zacsketches/MaryLou/Datasheets/Simpson.jpeg

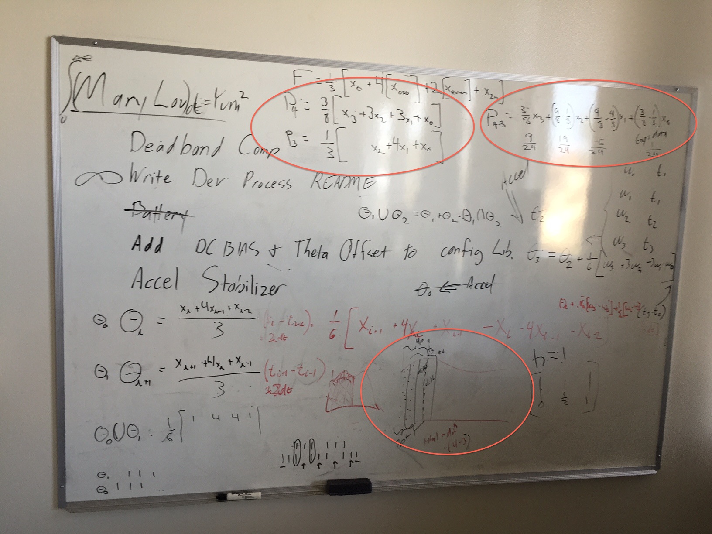
Datasheets/Simpson.jpeg
