zacsketches/MaryLou/build_notes.txt

Bill of Materials:
     Glow Worm robotics framework
     Arduino Due
     Arduino Motor Shield
     Pololu 10 DOF IMU v2
     XBEE
     3-cell lipo battery
     2 x Pololu 37D mm 19:1 gearmotor
     2 x Pololu stamped Al L-Bracket for 37D mm gearmotors
     2 x Pololu universal mounting hubs
     2 x Pololu ?? x 8mm wheels
     4 x 3/4" nylon standoffs
     custom power and signal distribution boards
     
1. Start here on Due and motor shield
     http://arduino.cc/en/Tutorial/DueMotorShieldDC

2. Great ref for quadrature encoding
    http://letsmakerobots.com/node/24031

3. The plant will need to attach two encoder motors and
subscribe to the control_effort message.  It will
publish a plant status message with the following fields
    long rt_ct
    float rt_I //mv
    long lt_ct
    float lt_I
    uint32_t timestamp   //microseconds
    
5. Consider having the plant balance counts between the
two motors.
    
4. The attitude computer will hold pointers to an accel object 
and a magnetometer object, and will need to publish a message
called pitch with the following data:
    int theta    //pitch neg falling back, pos frwd
    uint32_t timestamp   //microseconds
    
5. The state observer will subscribe to the 
pitch message and the plant_status_msg and publish
the state_vec_msg with the following fields
    double theta
    double theta_dot
    double x
    double x_dot
    
6. The balance regulator will subscribe to the 
state_vec_msg and publish the control_effort_msg
with the following field:
    int u
    
7. Have clearinghouse use publish_serial on the
messages of interest for debugging.

8. //Physical connections
const int lt_dir_pin = 12;
const int lt_pwm_pin = 3;
const int lt_sense_pin = A0;
const int lt_encoder_A_pin = 7;
const int lt_encoder_B_pin = 6;

const int rt_dir_pin = 13;
const int rt_pwm_pin = 11;
const int rt_sense_pin = A1;
const int rt_encoder_A_pin = 5;
const int rt_encoder_B_pin = 4;

9. Outstanding resource for IMU info:
     https://code.google.com/p/ardu-imu/wiki/Theory
     
10. The atan or atan2 function is used to calculate pitch
angle directly from the accelerometer.  The Freescale 
Application Note 3461 gives an outstanding explanation of
this.  See AN3461 in the Datasheets folder of the 
project.

11. The atan and atan2 functions resolve their 
result with differing rules about quadrants.  In 
essence atan give a result only in quadrant I or IV.
Whereas atan2 solves for the result in all four 
quadrants.  See this link for a thorough explanation:
    http://stackoverflow.com/questions/283406/what-is-the-difference-between-atan-and-atan2-in-c
    
12. Used basic technique for PI controller tuning on the 
attitude computer with ideas from Zeiger-Nichols method.  
See here for an overview:
     http://en.wikipedia.org/wiki/Ziegler%E2%80%93Nichols_method

13. The deadband lab saved in the datasheets is also a good reference
for control of an atmega32 on the same PCB as an L293.
     http://claymore.engineer.gvsu.edu/~jackh/eod/courses/egr345/fall05/lab_deadband.pdf
I implemented deadband compensation as a linear scaling.  Each gw::Motor now
has a function to set_deadband(int forward, int reverse).  PWM signals
falling between these values will be scaled with the Arduino map() function
like this:
	pwm_compensated = map(pwm_raw, 0, 255, deadband_limit, 255);
Then the compensated value will be written to the motor.  The gw::Motor
default values for deadband are (0,0).  So if they are not set then no
scaling will occur.
    
14. The MATLAB example for control of an inverted pendulum is a great
reference for the statespace controller necessary for this project.
	http://ctms.engin.umich.edu/CTMS/index.php?example=InvertedPendulum&section=SystemModeling

15. Wikipedia has a good article on moments of inertia. I think we will
be able to compute the moment of inertia for our pendulum based off
the system they give for compound pendulums.

16. MATLAB equations of motion, where phi is the linearized theta:
	(I+m*l^2)phi_double_dot - m*g*l*phi = m*l*x_double_dot
	(M+m)x_double_dot + b*x_dot - m*l*phi_double_dot = u
	
17. Ogata has the same equations, but does not consider the x_dot friction
component in the second equation.  We might need to take this route because
it's going to be hard to measure friction between the tires and body.  Finally,
there is an interesting discussion from Stanford at:
	http://web.stanford.edu/class/me161/documents/InvertedPendulumOnCartSolution.pdf

18. Because MaryLou is an irregular shape computing I, necessary for the equations
in note 16, is not trivial.  See these YouTube videos for background on 
computing the Mass Moment of Inertia by suspending it from the ceiling.
	https://www.youtube.com/watch?v=m9iHEanmNWc
	https://www.youtube.com/watch?v=tfrzMczTv8g
	https://www.youtube.com/watch?v=4lcVQzdK_vE

19. I found a good resource on committing just a single file or group of files from
one branch into another.  I've included it here so I can find it again later.
	http://jasonrudolph.com/blog/2009/02/25/git-tip-how-to-merge-specific-files-from-another-branch/
