zacsketches/MaryLou/Solidworks/Frame.SLDASM

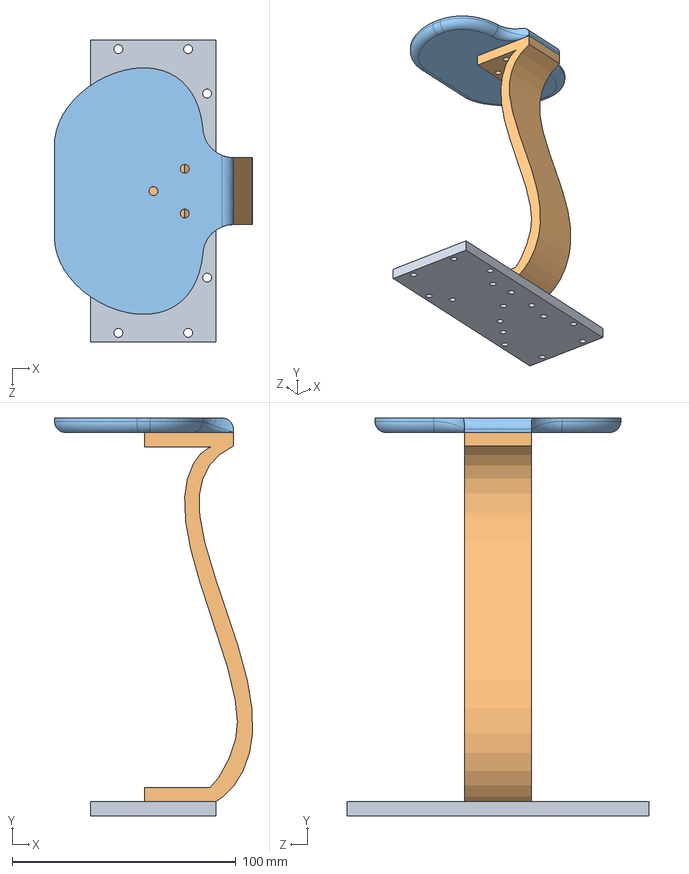
[picture p2: CAD file, 2014-10-09]
Solidworks/Frame.SLDASM
88.6 x 178.0 x 134.9 mm
baseplate
neck
Table
