zacsketches/MaryLou/Solidworks/neck.SLDPRT

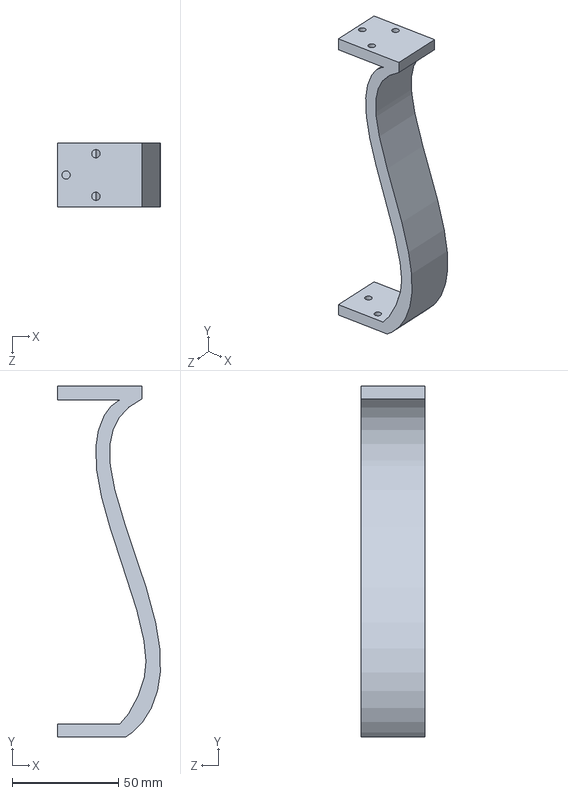
[picture p3: CAD file, 2014-10-25]
Solidworks/neck.SLDPRT
48.3 x 165.0 x 30.0 mm
