zacsketches/MaryLou/Solidworks/Table.SLDPRT

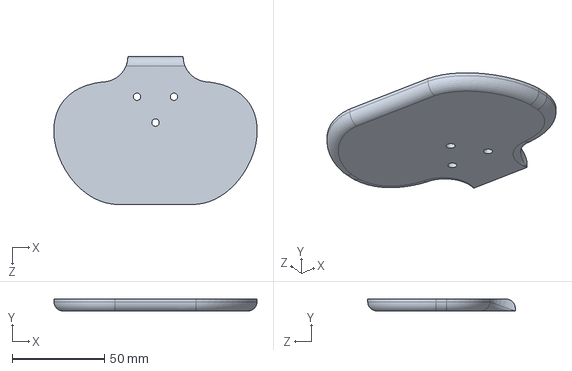
[picture p4: CAD file, 2014-10-09]
Solidworks/Table.SLDPRT
110.0 x 6.50 x 80.0 mm
