zacsketches/MaryLou/Solidworks/baseplate.SLDPRT

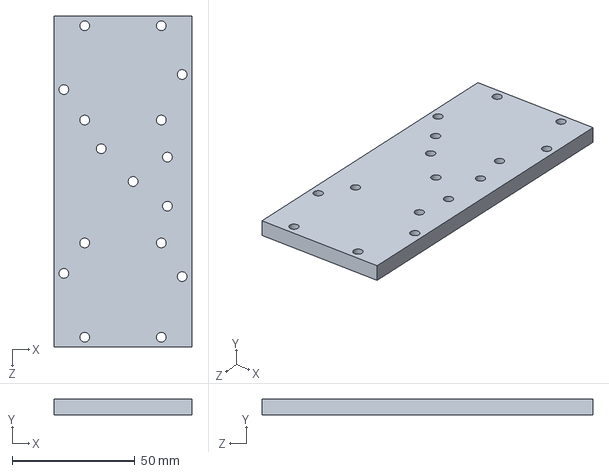
[picture p5: CAD file, 2014-10-08]
Solidworks/baseplate.SLDPRT
56.2 x 6.50 x 134.9 mm
