zacsketches/MaryLou/(list of files, cad)

Other CAD files:
Solidworks/Table.STL
Solidworks/baseplate.SLDDRW
Solidworks/baseplate.STL
Solidworks/neck.SLDDRW
Solidworks/neck.STL
