zacsketches/MaryLou/(list of files, drawings)

Other design files:
PCBs/lower.pcb
PCBs/top.pcb
PCBs/upper_pcb/top.pcb
