zacsketches/MaryLou/PCBs/LowerBoard_r1.brd

## EAGLE design PCBs/LowerBoard_r1.brd (2014-12-12)

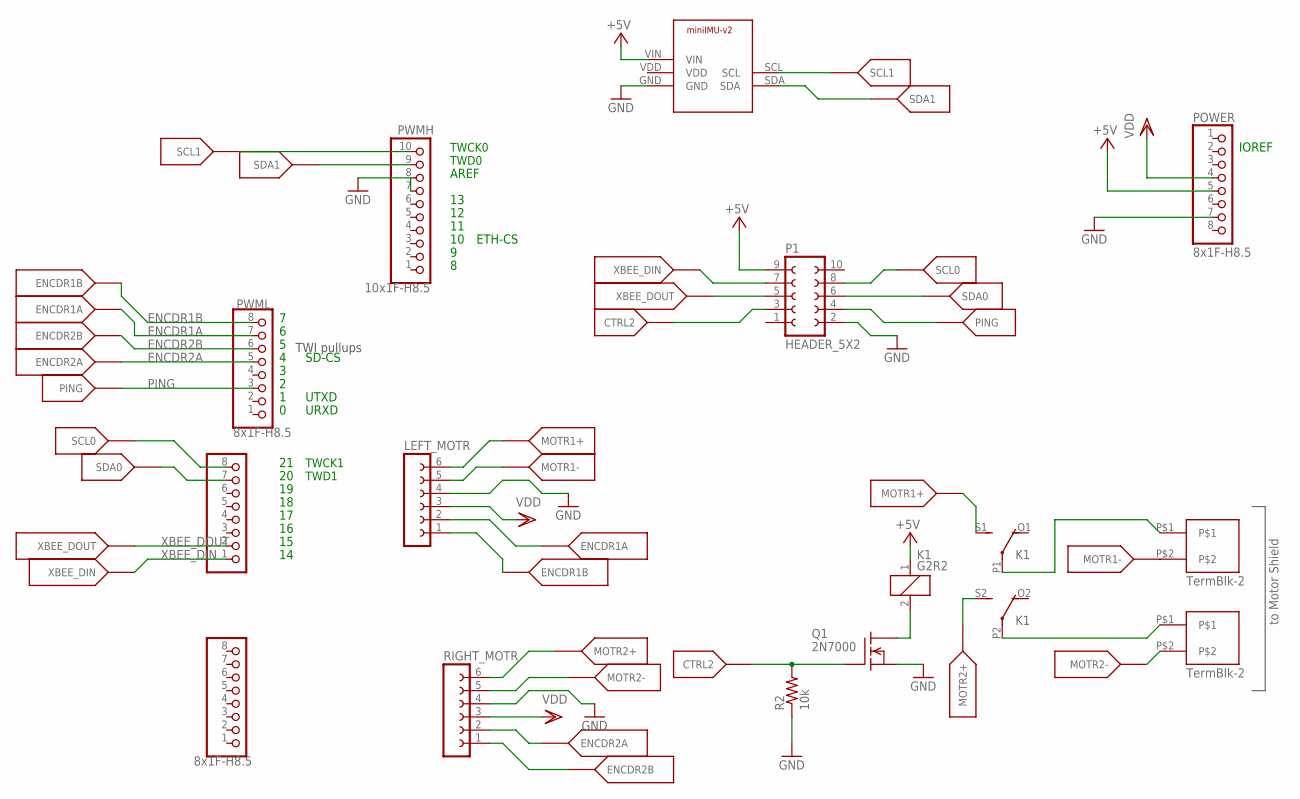
[picture p6: schematic LowerBoard_r1.sch]

Parts:
ANALOG: 8x1F-H8.5; 1X08
COMMS: PINHD-1X8; 1X08
K1: G2R2
LEFT_MOTR: FE06-1; FE06
P1: HEADER_5X2
POWER: 8x1F-H8.5; 1X08
PWMH: 10x1F-H8.5; 1X10
PWML: 8x1F-H8.5; 1X08
Q1: 2N7000; TO92
R2: 10k; RESISTOR_PKG
RIGHT_MOTR: FE06-1; FE06
U$5: POLOLU_MINIIMU9_V2; POLOLU_IMU9V2
U$11: motor1; TB2_PKG
U$12: TB2; TB2_PKG

Connections:
+5V: K1.1, P1.9, POWER.5, U$5.VIN
CTRL2: P1.3, Q1.G, R2.2
ENCDR1A: LEFT_MOTR.2, PWML.7
ENCDR1B: LEFT_MOTR.1, PWML.8
ENCDR2A: PWML.5, RIGHT_MOTR.2
ENCDR2B: PWML.6, RIGHT_MOTR.1
GND: LEFT_MOTR.4, P1.2, POWER.7, PWMH.7, Q1.S, R2.1, RIGHT_MOTR.4, U$5.GND
MOTR1+: K1.S1 (S), LEFT_MOTR.6
MOTR1-: LEFT_MOTR.5, U$11.P$2
MOTR2+: K1.S2 (S), RIGHT_MOTR.6
MOTR2-: RIGHT_MOTR.5, U$12.P$2
unnamed: K1.P1, U$11.P$1
unnamed: K1.P2, U$12.P$1
unnamed: K1.2, Q1.D
PING: P1.4, PWML.3
SCL: PWMH.10, U$5.SCL
SCL0: COMMS.8, P1.8
SDA: PWMH.9, U$5.SDA
SDA0: COMMS.7, P1.6
VDD: LEFT_MOTR.3, POWER.4, RIGHT_MOTR.3
XBEE_DIN: COMMS.1, P1.7
XBEE_DOUT: COMMS.2, P1.5

Notes on the sheet:
TWI pullups
TWCK1
TWD1
IOREF
TWCK0
TWD0
AREF
SD-CS
UTXD
URXD
ETH-CS
to Motor Shield

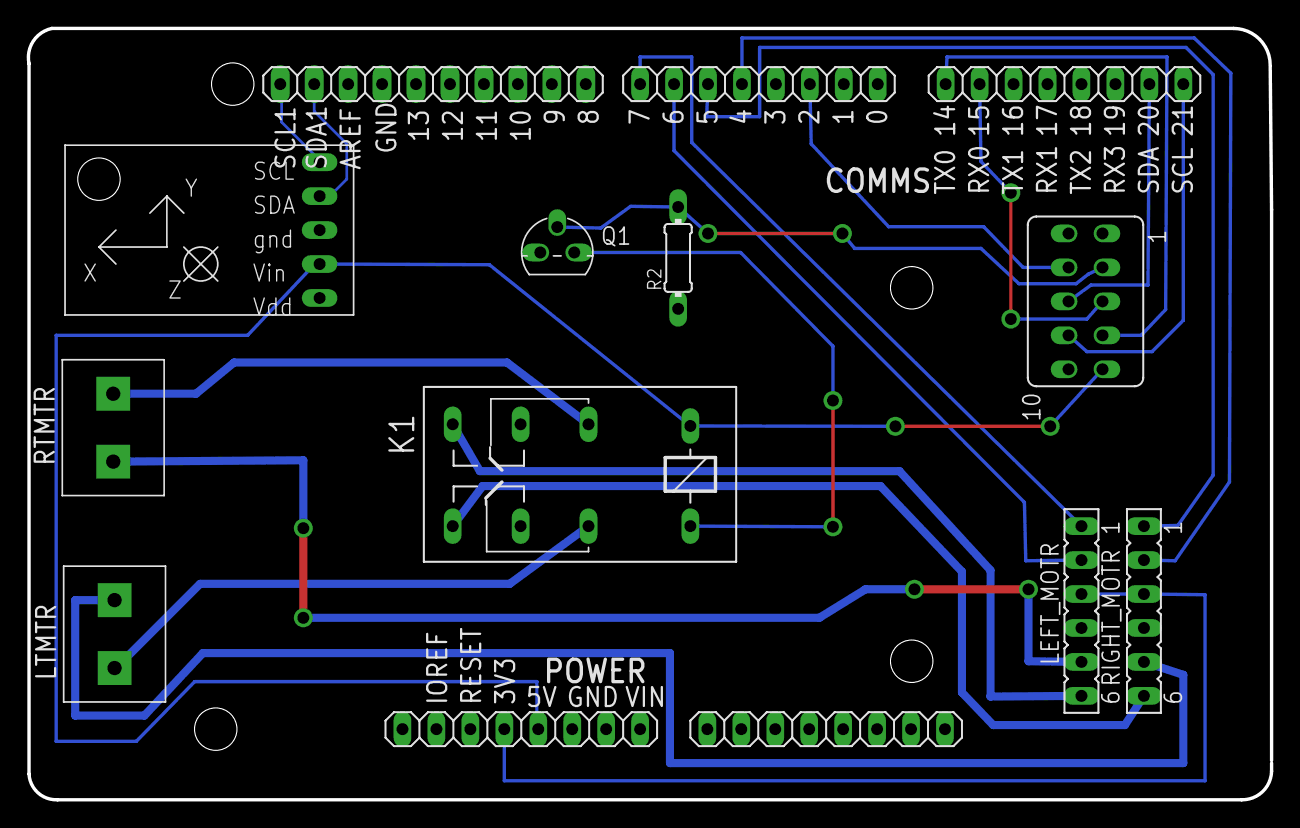
[picture p7: board LowerBoard_r1.brd from above]

Board: 2 copper layers, 93.0 x 57.7 mm, 15 parts (0 on the bottom side), 22 nets.

Other parts of the board:
DRILEGEND: DRILEGEND
