zacsketches/MaryLou/PCBs/upper_pcb/upperBoard.brd

## EAGLE design PCBs/upper_pcb/upperBoard.brd (2014-12-12)

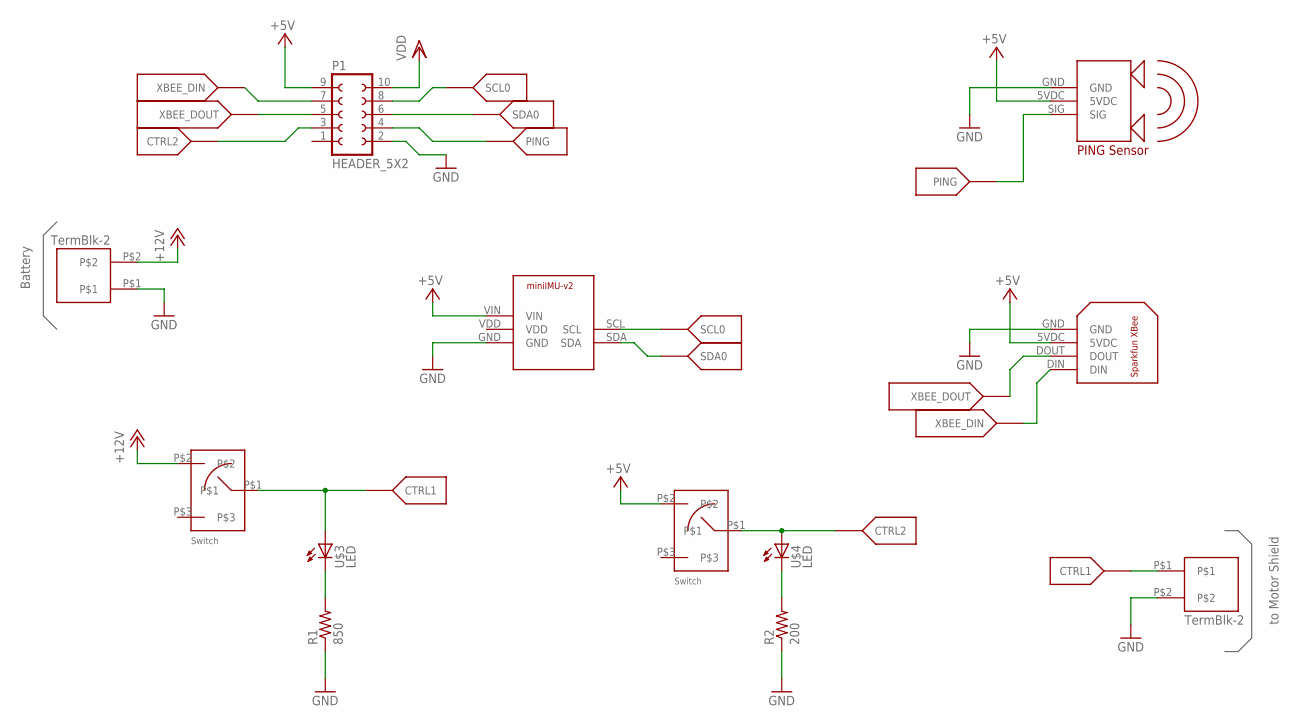
[picture p8: schematic upperBoard.sch]

Parts:
P1: HEADER_5X2
R1: 850; RESISTOR_PKG
R2: 200; RESISTOR_PKG
U$1, U$2: SWITCH-SPST
U$3, U$4: LED; LED_PKG
U$7: POLOLU_MINIIMU9_V2; POLOLU_IMU9V2
U$8: SPARKFUNXBEE
U$9: PARALLAX_PING; PING
U$16, U$18: TB2; TB2_PKG

Connections:
+5V: P1.9, U$2.P$2, U$7.VIN, U$8.5VDC, U$9.5VDC
+12V: U$1.P$2, U$16.P$2
CTRL1: U$1.P$1, U$3.A, U$18.P$1
CTRL2: P1.3, U$2.P$1, U$4.A
GND: P1.2, R1.1, R2.1, U$7.GND, U$8.GND, U$9.GND, U$16.P$1, U$18.P$2
unnamed: R1.2, U$3.K (C)
unnamed: R2.2, U$4.K (C)
PING: P1.4, U$9.SIG
SCL0: P1.8, U$7.SCL
SDA0: P1.6, U$7.SDA
VDD: P1.10
XBEE_DIN: P1.7, U$8.DIN
XBEE_DOUT: P1.5, U$8.DOUT

Notes on the sheet:
Battery
to Motor Shield

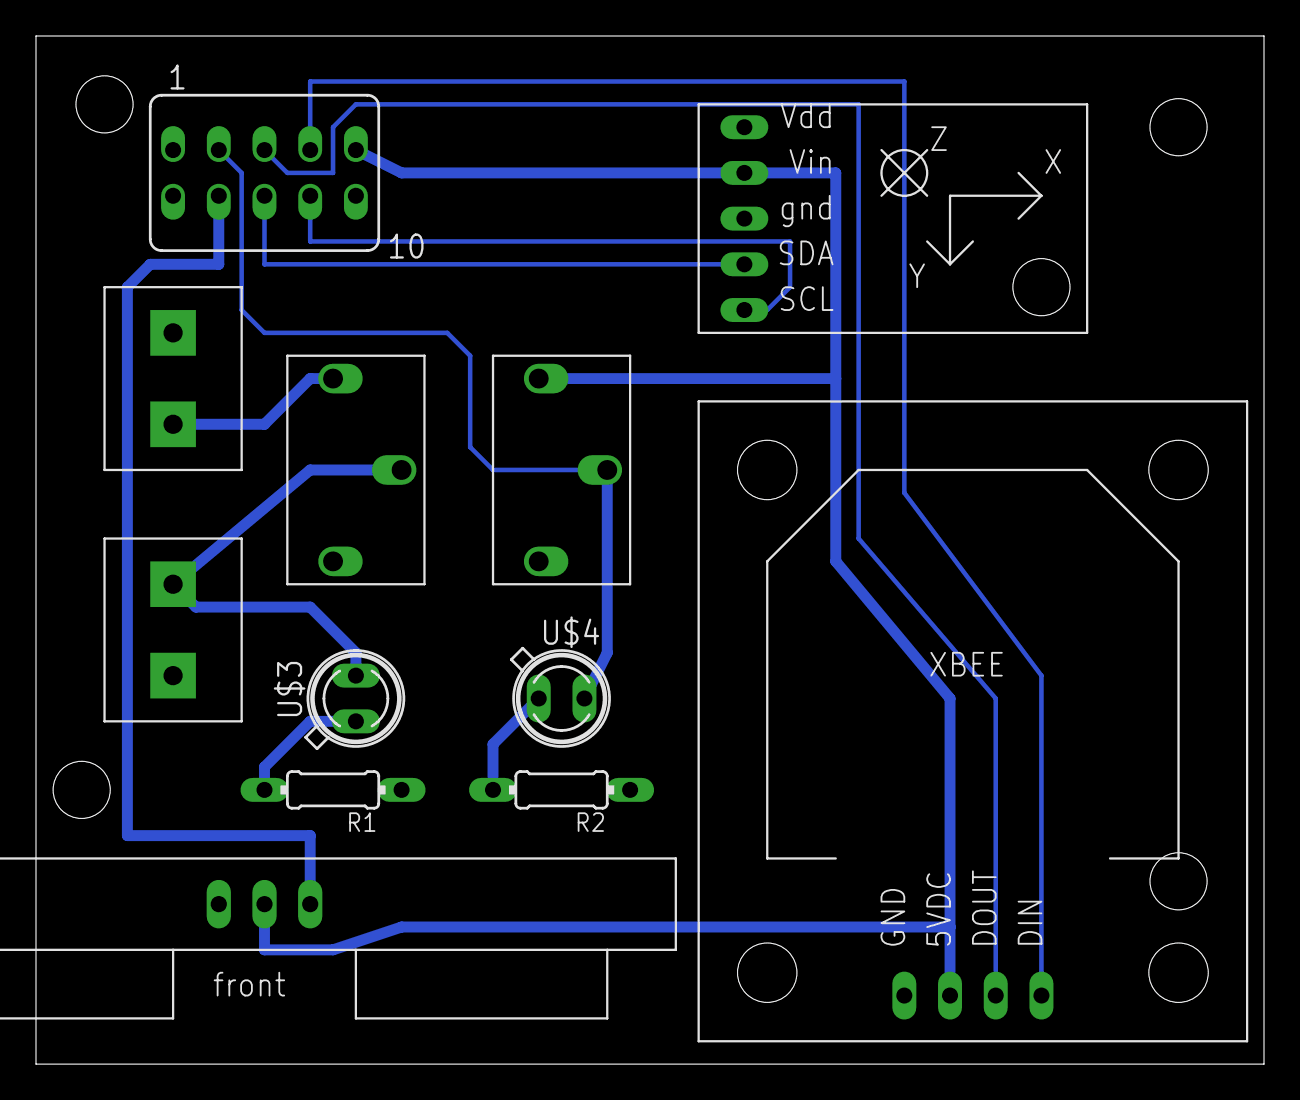
[picture p9: board upperBoard.brd from above]

Board: 2 copper layers, 68.2 x 57.1 mm, 13 parts (0 on the bottom side), 12 nets.

Other parts of the board:
DRILEGEND: DRILEGEND
