zacsketches/MaryLou/(commit log)

2014-10-08 added solidworks files to the project
    [arduino-due-or-mega-holes.SLDPRT, baseplate.SLDDRW, baseplate.SLDPRT, baseplate.STL, neck.SLDPRT, neck.STL]
2014-10-08 added Frame assembly and new Baseplate
    the new Frame assembly includes the mates for
    all the parts. The new Baseplate includes
    the mounting holes for the Neck.
    [Frame.SLDASM, baseplate.STL]
2014-10-09 added table and neck drawing
    [Frame.SLDASM, Table.SLDPRT, Table.STL, neck.SLDDRW, neck.SLDPRT]
2014-10-10 Added bill of materials
2014-10-14 major changes
    - Rebuilt file structure to seperate code from physical data
    and reference data
    - Wrote the first code in gyro_test to start working with Pololu
    IMU v2.
    [Frame.SLDASM, Table.SLDPRT, Table.STL, baseplate.SLDDRW, baseplate.SLDPRT, baseplate.STL, neck.SLDDRW, neck.SLDPRT]
2014-10-14 gyro_test compiles...ready for testing e
2014-10-14 added conv to deg to the gyro test
2014-10-15 Added link for IMU info
2014-10-15 Working accelerometer script
2014-10-15 correctd the units to degrees function
    [gyro_test.ino]
2014-10-15 Pitch regulator example added
2014-10-16 compiles...lot's of work still
    - I need to go back into my accel test and change the formula there
    so I get a signed value for pitch. I can't regulate the pitch
    from the gyro until I'm getting like signs from both devices.
2014-10-16 added app note for finding pitch
2014-10-16 used new pitch solution with a signed answer.
2014-10-16 Changed to direct calculation of pitch
    - An important change in this revision, I changed from a
    vector solution to pitch using dot products to a direct
    calculation of pitch using the technique described in
    Freescale App Note 3461.
2014-10-16 Closed issue #1 - adde macro logging
    [base.ino]
2014-10-16 Yahoo!!! Regulates gyro stability to +/- .3 deg
    - Tuned the PI controller and changed the sign for the
    error signal provide negative feedback.
    [gyro_drift_regulator.ino]
2014-10-16 added gyro system diagram to datasheets
2014-10-16 Fine tuned the gyro drift regulator...go with this for now.
    [gyro_drift_regulator.ino]
2014-10-17 changed phi to theta for pitch variable
2014-10-25 added Nise references and updated build notes
    [neck.SLDPRT]
2014-11-13 Added PCB files for lower board
    [LowerBoard_r1.brd, LowerBoard_r1.sch]
2014-11-14 finished eagle file for lower PCB
    [DRILEGEND.CFG, LowerBoard_r1.brd, LowerBoard_r1.sch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]
2014-11-14 added PCB Cam file
    [lower.pcb]
2014-11-15 first atttempt to cut
    [lower.pcb]
2014-12-05 Added motor test
2014-12-10 updated accel test to due sec I2C port
2014-12-12 pcb info for top and bottom
    [LowerBoard_r1.brd, top.pcb, upperBoard.brd, upperBoard.sch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]
2014-12-12 Printed version of top circuit board
    [top.pcb]
2014-12-13 Two important changes
    - Added Simpson rule integration for the gyro. This calculation
    should provide a slight improvement over the trap z integration
    I was previously running. This effectively allows me to run
    a filter over four steps of data.
    - I corrected errrors in the PI controller to that were eliminating
    the input from the I component. I also changed the PI controller
    to accept both standard and parallel forms of the equation, with
    the system now configured to run on the standard form.
    [gyro_drift_regulator.ino]
2014-12-14 Multiple changes to move the project ahead
    Added three dev sketches
    - quadrature_decoder uses the raw addresses of the encoders
    to ensure I can count movement on the installed equipment
    - basic_gw_quadrature wraps the success in the basic
    quadrature in the glow worm framework and validates that it
    works. You have to turn the wheels by hand for these sketches.
    - dead_band_solver powers the wheels and measures how much
    control effort is necessary to turn them given motor and
    friction constraints. Initial data from this test was stored
    in the MaryLou.h configuration file.
2014-12-14 Added the config file to the repo.
    I need to add a link in the actual Arduino/library folder so that
    this config file is updated and used.
2014-12-16 Added a print statement before the delay
